DrVector-000/A2600-Cartridge-Dumper/Games DB/Off The Wall [CX26168] [ATARI] [1989] [PAL].MD

# Atari 2600 - Off The Wall

<p align="center" width="100%">
	Cartridge Front
</p>
<p align="center" width="100%">
	Cartridge Front
	Cartridge Top
	Cartridge Back
</p> <br/>

## Game information

**Game Title:** Off The Wall <br/>
**Game Code:** CX26168 <br/>
**Language:** English <br/>
**Publisher:** Atari Corporation <br/>
**Year:** 1989 <br/>
<br/>

## ROM information

**Bankswitch Method:** Atari 16 KB (F6) <br/>
<br/>

## PCB Information

<p align="center" width="100%">
	PCB Front
	PCB Back
</p>
<br/>

## Manual
