DrVector-000/A2600-Cartridge-Dumper/Games DB/RealSports Soccer [CX2667P] [ATARI] [1983] [PAL].MD

# Atari 2600 - RealSports Soccer

<p align="center" width="100%">
	Cartridge Front
</p>
<p align="center" width="100%">
	Cartridge Front
	Cartridge Top
	Cartridge Back
</p> <br/>

## Game information

**Game Title:** RealSports Soccer <br/>
**Game Code:** CX2667P <br/>
**Language:** English <br/>
**Publisher:** Atari Corporation <br/>
**Year:** 1983 <br/>
<br/>

## ROM information

**Bankswitch Method:** Atari 8 KB (F8) <br/>
<br/>

## PCB Information

<p align="center" width="100%">
	PCB Front
	PCB Back
</p>
<br/>

## Manual
