DrVector-000/A2600-Cartridge-Dumper/Games DB/Laser Blast [AG008] [Activision] [1981] [PAL].MD

# Atari 2600 - Laser Blast

<p align="center" width="100%">
	Cartridge Front
	Cartridge Top
	Cartridge Back
</p> <br/>

## Game information

**Game Title:** Laser Blast <br/>
**Game Code:** AG008 <br/>
**Language:** English <br/>
**Publisher:** Activision <br/>
**Year:** 1981 <br/>
<br/>

## ROM information

**Bankswitch Method:** Standard 2 KB (not bankswitched) <br/>
<br/>

## PCB Information

## Manual
