DrVector-000/A2600-Cartridge-Dumper/Games DB/Millipede [CX26118P] [Atari] [1987] [PAL].MD

# Atari 2600 - Millipede

<p align="center" width="100%">
	Cartridge Front
	Cartridge Top
	Cartridge Top
</p> <br/>

## Game information

**Game Title:** Millipede <br/>
**Game Code:** CX26118P <br/>
**Language:** English <br/>
**Publisher:** Atari <br/>
**Year:** 1987 <br/>
<br/>

## ROM information

**Bankswitch Method:** Atari 16 KB (F6) <br/>
<br/>

## PCB Information

## Manual
