DrVector-000/A2600-Cartridge-Dumper/Games DB/Combat [CX2601][Atari] [1977] [PAL].MD

# Atari 2600 - Combat

<p align="center" width="100%">
	Cartridge Front
	Cartridge Top
	Cartridge Back
</p> <br/>

## Game information

**Game Title:** Combat <br/>
**Game Code:** CX2601 <br/>
**Language:** English <br/>
**Publisher:** Atari <br/>
**Year:** 1977 <br/>
<br/>

## ROM information

**Bankswitch Method:** Standard 2 KB (not bankswitched) <br/>
<br/>

## PCB Information

<p align="center" width="100%">
	PCB Front
	PCB Back
</p>

## Manual
