DrVector-000/A2600-Cartridge-Dumper/Games DB/Apriti, Sesamo [CVA204] [BIT] [1982] [PAL].MD

# Atari 2600 - Apriti, Sesamo

<p align="center" width="100%">
	Cartridge Front
	Cartridge Top
	Cartridge Top
</p> <br/>

## Game information

**Game Title:** Apriti, Sesamo <br/>
**Game Code:** CVA204 <br/>
**Language:** Italian <br/>
**Publisher:** Bit Corporation / FujiStyle <br/>
**Year:** 1982 <br/>
<br/>

## ROM information

**Bankswitch Method:** Standard 4 KB (not bankswitched) <br/>
<br/>

## PCB Information

<p align="center" width="100%">
	PCB Front
	PCB Back
</p>
<br/>

## Manual

[Apriti, Sesamo - Manual (ITA)](https://archive.org/download/A26_APRITI_SESAMO_CVA204/APRITI_SESAMO_MANUAL.pdf)
