DrVector-000/A2600-Cartridge-Dumper/Games DB/Basketball [CX2624] [ATARI] [1987] [PAL].MD

# Atari 2600 - Basketball

<p align="center" width="100%">
	Cartridge Front
	Cartridge Top
	Cartridge Front
</p> <br/>

## Game information

**Game Title:** Basketball <br/>
**Game Code:** CX2624 <br/>
**Publisher:** Atari Corp. <br/>
**Year:** 1987 <br/>
<br/>

## ROM information

**Bankswitch Method:** Standard 2 KB (not bankswitched) <br/>
<br/>

## PCB Information

<p align="center" width="100%">
	PCB Front
	PCB Back
</p>
