DrVector-000/A2600-Cartridge-Dumper/Games DB/Dark Chambers [CX26151P] [Atari] [1988] [PAL].MD

# Atari 2600 - Dark Chambers

<p align="center" width="100%">
	Cartridge Front
	Cartridge Top
	Cartridge Top
</p> <br/>

## Game information

**Game Title:** Dark Chambers <br/>
**Game Code:** CX26151P <br/>
**Language:** English <br/>
**Publisher:** Atari <br/>
**Year:** 1988 <br/>
<br/>

## ROM information

**Bankswitch Method:** Atari 16 KB (F6) <br/>
<br/>

## PCB Information

## Manual
