DrVector-000/A2600-Cartridge-Dumper/Games DB/Double Dunk [CX26159] [Atari] [1988] [PAL].MD

# Atari 2600 - Double Dunk

<p align="center" width="100%">
	Cartridge Front
</p>
<p align="center" width="100%">
	Cartridge Front
	Cartridge Top
	Cartridge Top
</p>
<br/>

## Game information

**Game Title:** Double Dunk <br/>
**Game Code:** CX26159 <br/>
**Language:** English <br/>
**Publisher:** Atari <br/>
**Year:** 1988 <br/>
<br/>

## ROM information

**Bankswitch Method:** Atari 16 KB (F6) <br/>
<br/>

## PCB Information

## Manual
