DrVector-000/A2600-Cartridge-Dumper/Games DB/Football - RealSports Soccer [CX2667] [Atari] [1987] [PAL].MD

# Atari 2600 - Football - RealSports Soccer

<p align="center" width="100%">
	Cartridge Front
	Cartridge Top
	Cartridge Back
</p> <br/>

## Game information

**Game Title:** Football - RealSports Soccer <br/>
**Game Code:** CX2667 <br/>
**Language:** English <br/>
**Publisher:** Atari <br/>
**Year:** 1987 <br/>
<br/>

## ROM information

**Bankswitch Method:** Atari 8 KB (F8) <br/>
<br/>

## PCB Information

## Manual
