DrVector-000/A2600-Cartridge-Dumper/Games DB/Phoenix [CX2673] [Atari] [1988] [PAL].MD

# Atari 2600 - Phoenix

<p align="center" width="100%">
	Cartridge Front
	Cartridge Top
	Cartridge Back
</p> <br/>

## Game information

**Game Title:** Phoenix <br/>
**Game Code:** CX2673 <br/>
**Language:** English <br/>
**Publisher:** Atari <br/>
**Year:** 1988 <br/>
<br/>

## ROM information

**Bankswitch Method:** Atari 8 KB (F8) <br/>
<br/>

## PCB Information

## Manual
