DrVector-000/A2600-Cartridge-Dumper/Games DB/Space Cavern [AP2002] [Apollo] [1982] [PAL].MD

# Atari 2600 - Space Cavern

<p align="center" width="100%">
	Cartridge Front
	Cartridge Top
	Cartridge Back
</p> <br/>

## Game information

**Game Title:** Space Cavern <br/>
**Game Code:** AP2002 <br/>
**Language:** English <br/>
**Publisher:** Games by Apollo <br/>
**Year:** 1982 <br/>
<br/>

## ROM information

**Bankswitch Method:** Standard 4 KB (not bankswitched) <br/>
<br/>

## PCB Information

## Manual
