DrVector-000/A2600-Cartridge-Dumper/Games DB/Midnight Magic [CX26129] [Atari] [1988] [PAL].MD

# Atari 2600 - Midnight Magic

<p align="center" width="100%">
	Cartridge Front
	Cartridge Top
	Cartridge Top
</p> <br/>

## Game information

**Game Title:** Midnight Magic <br/>
**Game Code:** CX26129 <br/>
**Language:** English <br/>
**Publisher:** Atari <br/>
**Year:** 1988 <br/>
<br/>

## ROM information

**Bankswitch Method:** Atari 16 KB (F6) <br/>
<br/>

## PCB Information

## Manual
