DrVector-000/A2600-Cartridge-Dumper/Games DB/Star Voyager [IA3201] [Imagic] [1982] [PAL].MD

# Atari 2600 - Star Voyager

<p align="center" width="100%">
	Cartridge Front
	Cartridge Top
	Cartridge Back
</p> <br/>

## Game information

**Game Title:** Star Voyager <br/>
**Game Code:** IA3201 <br/>
**Language:** English <br/>
**Publisher:** Imagic <br/>
**Year:** 1982 <br/>
<br/>

## ROM information

**Bankswitch Method:** Standard 4 KB (not bankswitched) <br/>
<br/>

## PCB Information

## Manual
