DrVector-000/A2600-Cartridge-Dumper/Games DB/Kangaroo [CX2689] [Atari] [1988] [PAL].MD

# Atari 2600 - Kangaroo

<p align="center" width="100%">
	Cartridge Front
	Cartridge Top
	Cartridge Back
</p> <br/>

## Game information

**Game Title:** Kangaroo <br/>
**Game Code:** CX2689 <br/>
**Language:** English <br/>
**Publisher:** Atari <br/>
**Year:** 1988 <br/>
<br/>

## ROM information

**Bankswitch Method:** Atari 8 KB (F8) <br/>
<br/>

## PCB Information

## Manual
