DrVector-000/A2600-Cartridge-Dumper/Games DB/Outlaw [CX2605P] [Atari] [1979] [PAL].MD

# Atari 2600 - Outlaw

<p align="center" width="100%">
	Cartridge Front
	Cartridge Top
	Cartridge Back
</p> <br/>

## Game information

**Game Title:** Outlaw <br/>
**Game Code:** CX2605P <br/>
**Publisher:** Atari, Inc <br/>
**Year:** 1979 <br/>
<br/>

## ROM information

**Bankswitch Method:** Standard 2 KB (not bankswitched) <br/>
<br/>

## PCB Information

## Manual
