DrVector-000/A2600-Cartridge-Dumper/Games DB/Dodge 'Em [CX2637] [Atari] [1987] [PAL].MD

# Atari 2600 - Dodge 'Em

<p align="center" width="100%">
	Cartridge Front
	Cartridge Top
	Cartridge Back
</p> <br/>

## Game information

**Game Title:** Dodge 'Em <br/>
**Game Code:** CX2637 <br/>
**Language:** English <br/>
**Publisher:** Atari <br/>
**Year:** 1987 <br/>
<br/>

## ROM information

**Bankswitch Method:** Standard 4 KB (not bankswitched) <br/>
<br/>

## PCB Information

## Manual
