DrVector-000/A2600-Cartridge-Dumper/Games DB/Ms. Pac-Man [CX2675] [Atari] [1982] [PAL].MD

# Atari 2600 - Ms. Pac-Man

<p align="center" width="100%">
	Cartridge Front
	Cartridge Top
	Cartridge Back
</p> <br/>

## Game information

**Game Title:** Ms. Pac-Man <br/>
**Game Code:** CX2675 <br/>
**Language:** English <br/>
**Publisher:** Atari Corporation <br/>
**Year:** 1982 <br/>
<br/>

## ROM information

**Bankswitch Method:** Atari 8 KB (F8) <br/>
<br/>

## PCB Information

## Manual
