DrVector-000/A2600-Cartridge-Dumper/Games DB/Super Football [CX26154] [Atari] [1988] [PAL].MD

# Atari 2600 - Super Football

<p align="center" width="100%">
	Cartridge Front
	Cartridge Top
	Cartridge Back
</p> <br/>

## Game information

**Game Title:** Super Football <br/>
**Game Code:** CX26154 <br/>
**Language:** English <br/>
**Publisher:** Atari Corporation <br/>
**Year:** 1988 <br/>
<br/>

## ROM information

**Bankswitch Method:** Atari 16 KB (F6) <br/>
<br/>

## PCB Information

## Manual
