DrVector-000/A2600-Cartridge-Dumper/Games DB/Battlezone [CX2681] [ATARI] [1987] [PAL].MD

# Atari 2600 - Battlezone

<p align="center" width="100%">
	Cartridge Front
	Cartridge Top
	Cartridge Back
</p> <br/>

## Game information

**Game Title:** Battlezone <br/>
**Game Code:** CX2681 <br/>
**Language:** English <br/>
**Publisher:** Atari Corp. <br/>
**Year:** 1987 <br/>
<br/>

## ROM information

**Bankswitch Method:** Atari 8 KB (F8) <br/>
<br/>

## PCB Information

## Manual
