DrVector-000/A2600-Cartridge-Dumper/Games DB/Super Baseball [CX26152] [ATARI] [1988] [PAL].MD

# Atari 2600 - Super Baseball

<p align="center" width="100%">
	Cartridge Front
	Cartridge Top
	Cartridge Back
</p> <br/>

## Game information

**Game Title:** Super Baseball <br/>
**Game Code:** CX26152 <br/>
**Language:** English <br/>
**Publisher:** Atari <br/>
**Year:** 1988 <br/>
<br/>

## ROM information

**Bankswitch Method:** Atari 16 KB (F6) <br/>
<br/>

## PCB Information

## Manual
