DrVector-000/A2600-Cartridge-Dumper/Games DB/Pole Position [CX2694] [NAMCO] [1982] [PAL].MD

# Atari 2600 - Pole Position

<p align="center" width="100%">
	Cartridge Front
	Cartridge Top
	Cartridge Top
</p> <br/>

## Game information

**Game Title:** Pole Position <br/>
**Game Code:** CX2694 <br/>
**Language:** English <br/>
**Publisher:** Namco <br/>
**Year:** 1982 <br/>
<br/>

## ROM information

**Bankswitch Method:** Atari 8 KB (F8) <br/>
<br/>

## PCB Information

## Manual
