DrVector-000/A2600-Cartridge-Dumper/Games DB/BMX Air Master [CX26190] [TNT GAMES] [1990] [PAL].MD

# Atari 2600 - BMX Air Master

<p align="center" width="100%">
	Cartridge Front
	Cartridge Top
	Cartridge Top
</p> <br/>

## Game information

**Game Title:** BMX Air Master <br/>
**Game Code:** CX26190 <br/>
**Language:** English <br/>
**Publisher:** TNT Games <br/>
**Year:** 1990 <br/>
<br/>

## ROM information

**Bankswitch Method:** Atari 16 KB (F6) <br/>
<br/>

## PCB Information

## Manual
