DrVector-000/A2600-Cartridge-Dumper/Games DB/Missile Command [CX2638] [Atari] [1980] [PAL].MD

# Atari 2600 - Missile Command

<p align="center" width="100%">
	Cartridge Front
	Cartridge Top
	Cartridge Top
</p> <br/>

## Game information

**Game Title:** Missile Command <br/>
**Game Code:** CX2638 <br/>
**Language:** English <br/>
**Publisher:** Atari <br/>
**Year:** 1980 <br/>
<br/>

## ROM information

**Bankswitch Method:** Standard 4 KB (not bankswitched) <br/>
<br/>

## PCB Information

## Manual
