DrVector-000/A2600-Cartridge-Dumper/Games DB/Desert Falcon [CX26140] [Atari] [1988] [PAL].MD

# Atari 2600 - Desert Falcon

<p align="center" width="100%">
	Cartridge Front
	Cartridge Top
	Cartridge Top
</p> <br/>

## Game information

**Game Title:** Desert Falcon <br/>
**Game Code:** CX26140 <br/>
**Language:** English <br/>
**Publisher:** Atari <br/>
**Year:** 1988 <br/>
<br/>

## ROM information

**Bankswitch Method:** Atari 16 KB (F6) <br/>
<br/>

## PCB Information

## Manual
