DrVector-000/A2600-Cartridge-Dumper/Games DB/Defender [CX2609] [Atari] [1981] [PAL].MD

# Atari 2600 - Defender

<p align="center" width="100%">
	Cartridge Front
	Cartridge Top
	Cartridge Top
</p> <br/>

## Game information

**Game Title:** Defender <br/>
**Game Code:** CX2609 <br/>
**Language:** English <br/>
**Publisher:** Atari <br/>
**Year:** 1981 <br/>
<br/>

## ROM information

**Bankswitch Method:** Standard 4 KB (not bankswitched) <br/>
<br/>

## PCB Information

## Manual
