DrVector-000/A2600-Cartridge-Dumper/Games DB/RealSports Tennis [CX2680P] [Atari] [1983] [PAL].MD

# Atari 2600 - RealSports Tennis

<p align="center" width="100%">
	Cartridge Front
	Cartridge Top
	Cartridge Top
</p> <br/>

## Game information

**Game Title:** RealSports Tennis <br/>
**Game Code:** CX2680P <br/>
**Language:** English <br/>
**Publisher:** Atari Corporation <br/>
**Year:** 1983 <br/>
<br/>

## ROM information

**Bankswitch Method:** Atari 8 KB (F8) <br/>
<br/>

## PCB Information
<br/>

## Manual
