DrVector-000/A2600-Cartridge-Dumper/Games DB/Jr. Pac-Man [CX26123] [Atari] [1987] [PAL].MD

# Atari 2600 - Jr. Pac-Man

<p align="center" width="100%">
	Cartridge Front
	Cartridge Top
	Cartridge Top
</p> <br/>

## Game information

**Game Title:** Jr. Pac-Man <br/>
**Game Code:** CX26123 <br/>
**Language:** English <br/>
**Publisher:** Atari <br/>
**Year:** 1987 <br/>
<br/>

## ROM information

**Bankswitch Method:** Atari 16 KB (F6) <br/>
<br/>

## PCB Information

## Manual
