DrVector-000/A2600-Cartridge-Dumper/Games DB/Crystal Castles [CX26110] [Atari] [1984] [PAL].MD

# Atari 2600 - Crystal Castles

<p align="center" width="100%">
	Cartridge Front
	Cartridge Top
	Cartridge Top
</p> <br/>

## Game information

**Game Title:** Crystal Castles <br/>
**Game Code:** CX26110 <br/>
**Language:** English <br/>
**Publisher:** Atari <br/>
**Year:** 1984 <br/>
<br/>

## ROM information

**Bankswitch Method:** Atari 16 KB (F6) <br/>
<br/>

## PCB Information

## Manual
