DrVector-000/A2600-Cartridge-Dumper/Images/PC_BACK_REV1.JPG

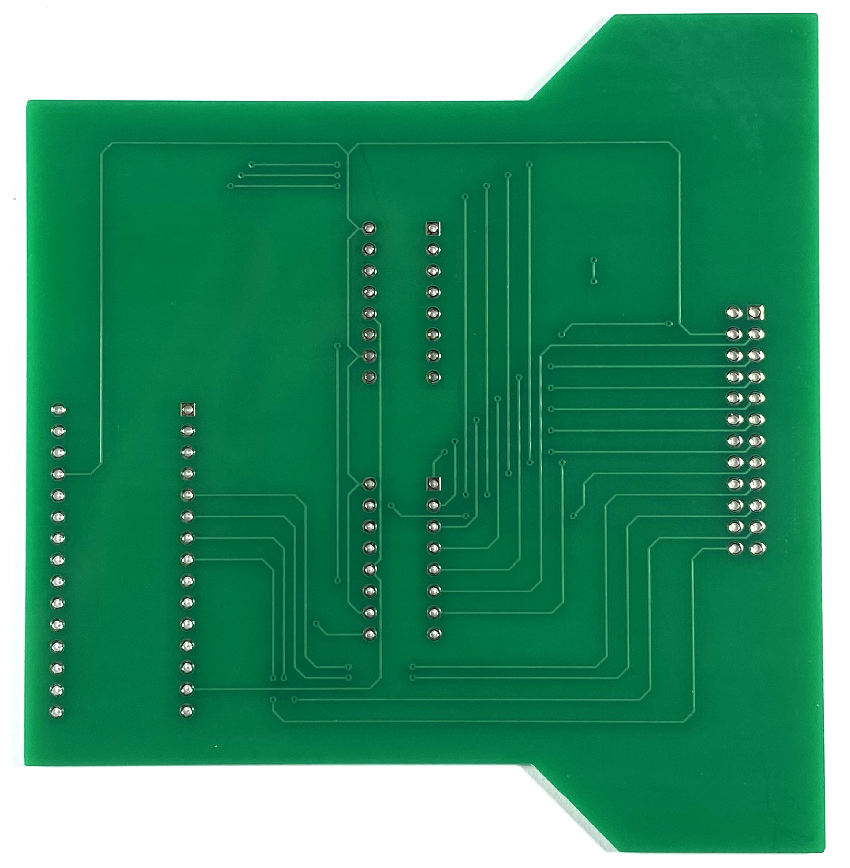
Images/PC_BACK_REV1.JPG
