DrVector-000/A2600-Cartridge-Dumper/Images/PCB_FRONT_REV1.JPG

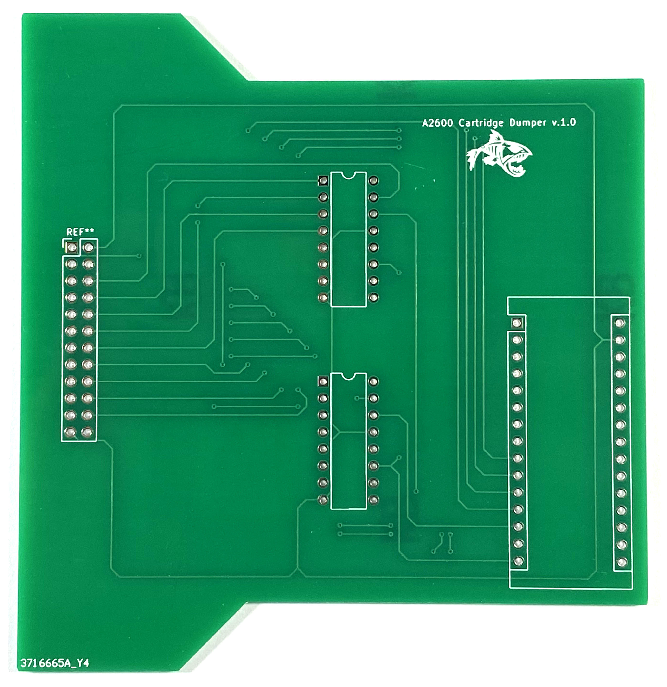
Images/PCB_FRONT_REV1.JPG
