DrVector-000/A2600-Cartridge-Dumper/Images/Prototipo_1.JPG

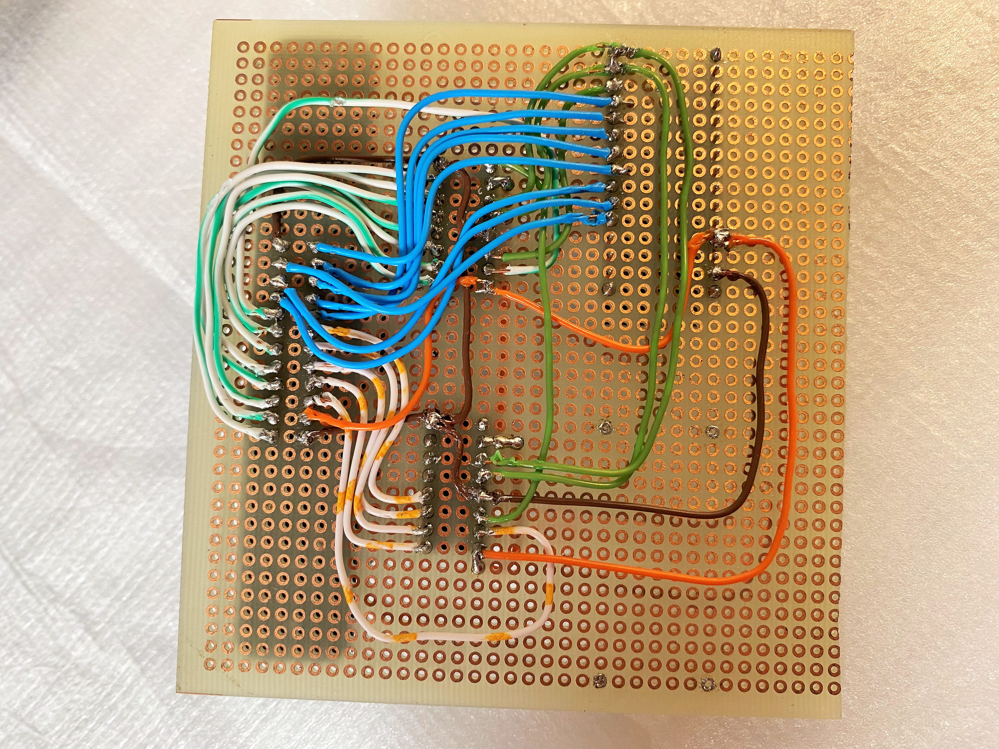
Images/Prototipo_1.JPG
