DrVector-000/A2600-Cartridge-Dumper/Images/Prototipo_2.JPG

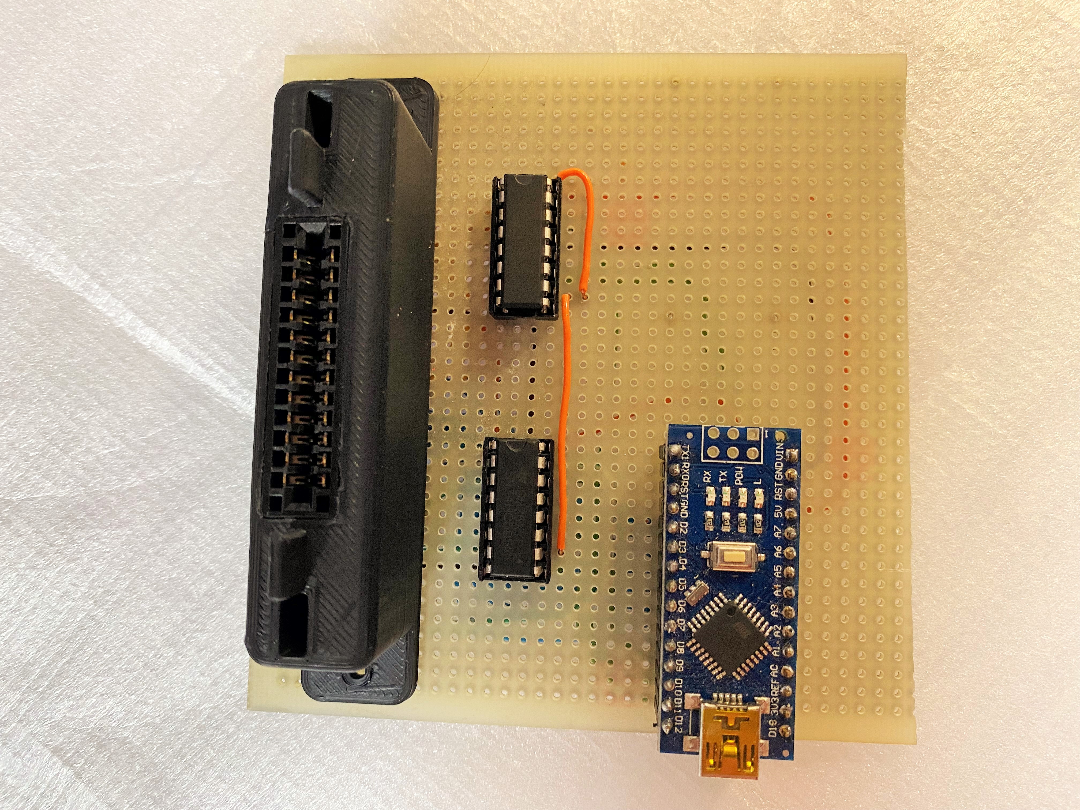
Images/Prototipo_2.JPG
