DrVector-000/A2600-Cartridge-Dumper/Images/Prototipo_3.JPG

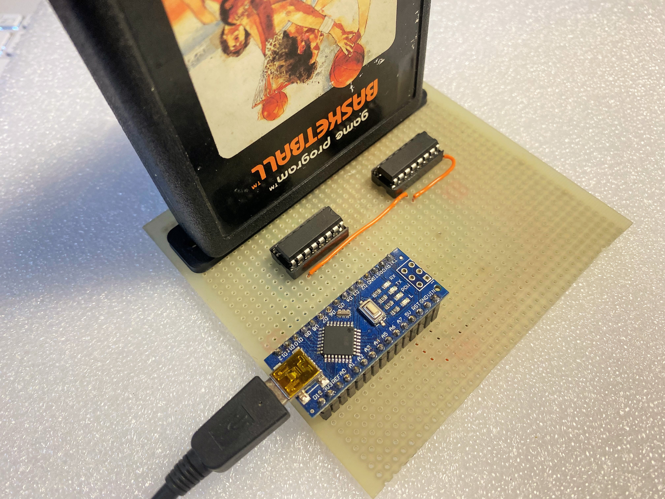
Images/Prototipo_3.JPG
