DrVector-000/A2600-Cartridge-Dumper/Images/Stella Basketball.png

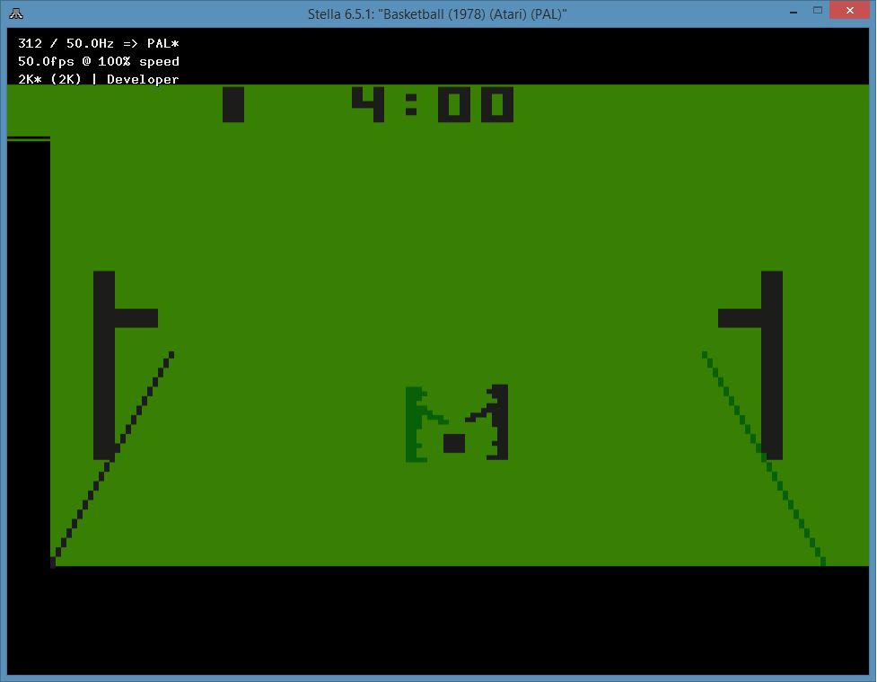
Images/Stella Basketball.png
