DrVector-000/A2600-Cartridge-Dumper/Docs/Manuale_A2600CD_rev1.pdf

### 1 Prerequisiti

Prima di procedere al collegamento ed avvio del software di gestione del dispositivo “A2600CartridgeDumper.exe” eseguire l’installazione, se necessario e non effettuato precedentemente, dei seguenti pacchetti software:

1. Driver del convertitore USB-Seriale presente nella scheda Arduino.
2. Pacchetto .Net Framework per Windows.

1.1 Installazione driver convertitore USB-Seriale

Per eseguire l’installazione del driver per il convertitore USB-Seriale CH340 troverete il pacchetto autoinstallante nel percorso:

Windows/Drivers/CH34x_InstallCH34x_Install_Windows_v3_4.zip_Windows_v3_4.zip

Decomprimete ed eseguite il file eseguibile.

A questo punto potrete collegare il dispositivo tramite il cavo USB ed in Gestione Dispositivi -> Porte (COM e LPT) sarà presente la porta seriale “USB-SERIAL CH340 (COMx)” dove la x indica il numero della porta seriale assegnata da Windows.

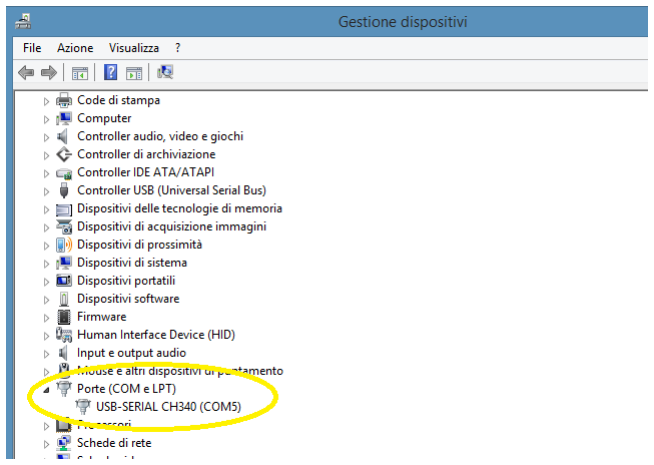
[picture p17: figure]

1.2 Installazione pacchetto .Net Framework per Windows

Solo nel caso in cui il software “A2600CartridgeDumper.exe” non dovesse avviarsi è necessario installare il pacchetto .Net Framework presente nella cartella:

Windows/.NET Framework/ndp472-kb4054530-x86-x64-allos-enu.exe

Figura 1- Finestra gestione dispositivi
