DrVector-000/A2600-Cartridge-Dumper/Images/Stella Debugger.png

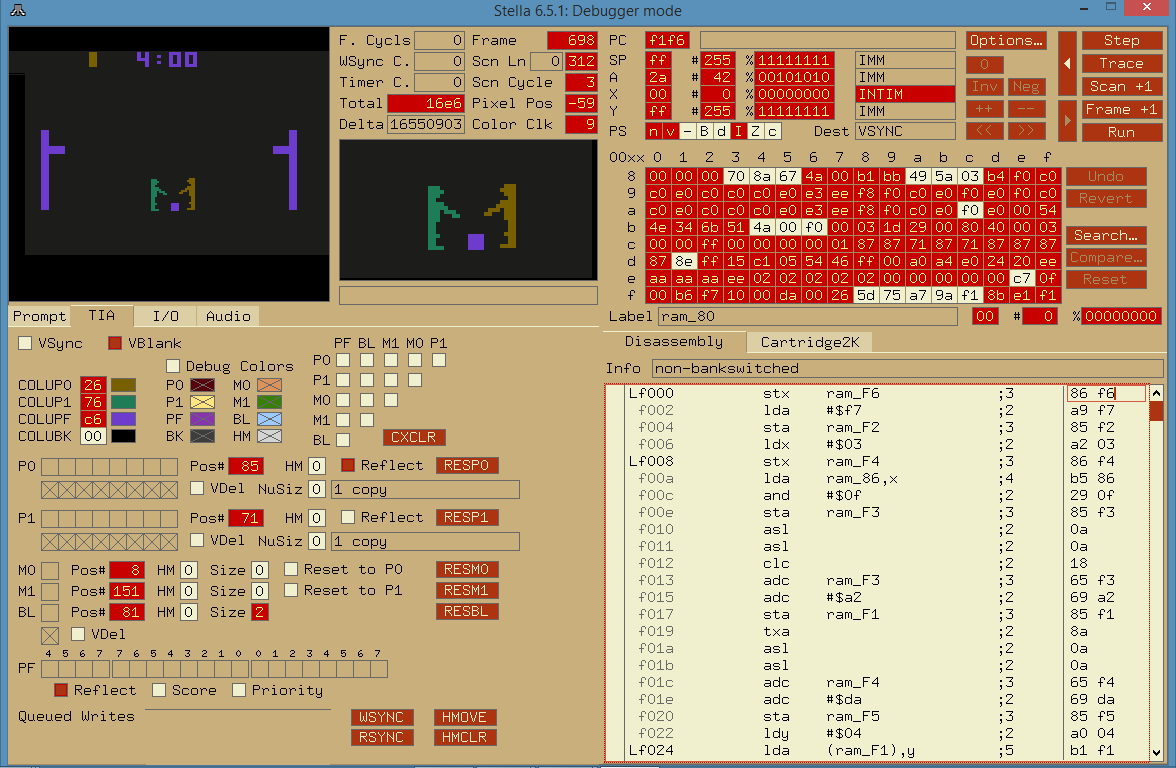
Images/Stella Debugger.png
