DrVector-000/A2600-Cartridge-Dumper/Arduino/A2600Dumper/A2600Dumper.ino

/*  
  A2600Dumper.ino - Atari 2600 Cartridge Dumper
  Copyright (C) 2022 DrVector
  Utilizza 74HC595 shift registers
*/

#include <Arduino.h>
#include "Const.h"
#include "SRHelper.h"
#include "A2600ROM.h"

//******************************************************************************************************************//
//* Variabili globali
//******************************************************************************************************************//
bool serialEcho = false;

//******************************************************************************************************************//
//* Setup
//******************************************************************************************************************//
void setup() {
  // Inizializza Ouput Pins per SN74HC595
  pinMode(SN_SRCLK_PIN, OUTPUT);
  pinMode(SN_SER_PIN, OUTPUT);
  pinMode(SN_RCLK_PIN, OUTPUT);

  // Imposta pin D2/D9 in INPUT
  for (int i = 2; i <= 9; i++) {
    pinMode(i, INPUT);
  }

  // Azzera lo shift register
  addressWrite(0x1000);

  Serial.begin(115200);
  //Serial.begin(500000);
  Serial.println("ATARI 2600 CARTRIDGE DUMPER V.1.00");
  Serial.println("");
}

//******************************************************************************************************************//
//* Ciclo principale
//******************************************************************************************************************//
void loop() {
  // Lettura porta seriale
  String s = ReadSerialComand();

  // Parsing dei comandi
  ParseComands(s);
}

//******************************************************************************************************************//
//* Comandi
//******************************************************************************************************************//
// Parsing dei comandi
void ParseComands(String s) {
  String params[10];

  s.toUpperCase();
  if (s != "") {
    if (serialEcho) {
      Serial.println(s);
    }

    String comand = GetComand(s);
    // Serial.println("COMAND: " + comand);
    //**********************************************
    // ECHO
    //**********************************************
    if (comand == "ECHO") {
      GetComandParams(s, params);
      // Serial.println("PARAM: " + params[0]);
      if (params[0] == "1") {
        serialEcho = true;
      }
      else if (params[0] == "0") {
        serialEcho = false;
      }
      else if (params[0] == "?") {
        Serial.println("+ECHO=" + String(serialEcho));
      }
    }
    //**********************************************
    // VERSION
    //**********************************************
    if (comand == "VERSION") {
      GetComandParams(s, params);
      // Serial.println("PARAM: " + params[0]);
      if (params[0] == "?") {
        Serial.println("+VERSION=0.001b");
      }
    }
    //**********************************************
    // READBYTE
    //**********************************************
    if (comand == "READBYTE") {
      GetComandParams(s, params);
      //Serial.println("PARAM: " + params[0]);
      if (params[0] != "") {
        byte b = readByte(params[0].toInt());
        Serial.println("+READBYTE=" + (String)b);
      }
    }
    //**********************************************
    // DUMPROM
    //**********************************************
    if (comand == "DUMPROM") {
      GetComandParams(s, params);
      //Serial.println("PARAM: " + params[0]);
      if (params[0] != "") {
        dumpROM(params[0].toInt(), -1);
        //Serial.println("+++");
      }
    }
    //**********************************************
    // DUMPROMBANKED
    //**********************************************
    if (comand == "DUMPROMBANKED") {
      GetComandParams(s, params);
      //Serial.println("PARAM: " + params[0]);
      if (params[0] != "") {
        dumpROMBanked(params[0].toInt());
        //Serial.println("+++");
      }
    }
  }
}

// Ritorna la stringa di comando
String GetComand(String s) {
  String comand = "";

  int i = s.indexOf('=');
  return s.substring(0, i);
}

// Ritorna lista parametri
void GetComandParams(String s, String(&params)[10]) {
  int index = s.indexOf('=');
  String par = s;
  par.remove(0, index + 1);
  
  for (int i = 0; i < 10; i++) {
    index = par.indexOf(',');
    if (index == -1) {
      int l = par.length();
      if (l > 0) {
        params[i] = par;
      }
      return;
    }
    else {
      params[i] = par.substring(0, index);
    }
  }
}

//******************************************************************************************************************//
//* Lettura comandi su porta seriale
//******************************************************************************************************************//
// Variabili globali
char receivedChars[64] = "";
int rcIndex = 0;

String ReadSerialComand(){
  while (Serial.available()) {
    if (rcIndex > 63) rcIndex = 0;
    
    // Legge carattere dalla seriale
    char rc = Serial.read();
    // Carattere di fine comando
    if (rc == '\n' or rc == '\r') {
      receivedChars[rcIndex] = '\0';
      rcIndex = 0;
      return receivedChars;
    }
    else {
      // Nuovo carattere
      receivedChars[rcIndex] = rc;
      rcIndex++;
    }
  }
  
  return "";
}
